Brummi/3D-Scanner/images/IMG_20150919_205852.jpg

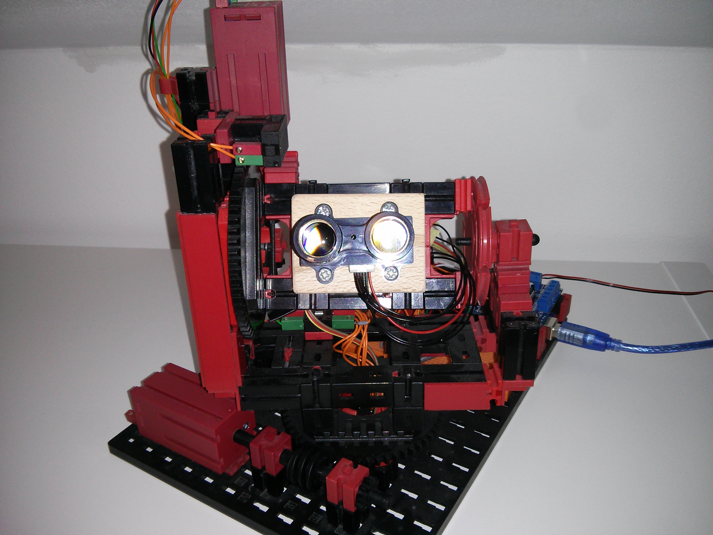
images/IMG_20150919_205852.jpg
