Brummi/3D-Scanner/images/scanner_vorne.jpg

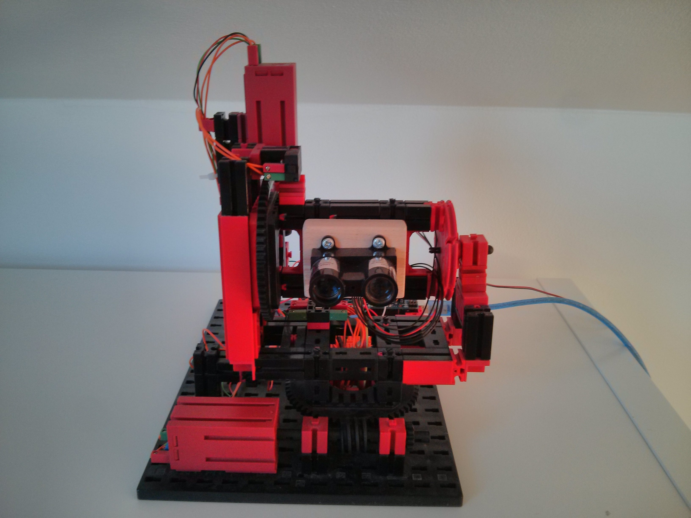
images/scanner_vorne.jpg
