Brummi/3D-Scanner/images/IMG_20150919_205907.jpg

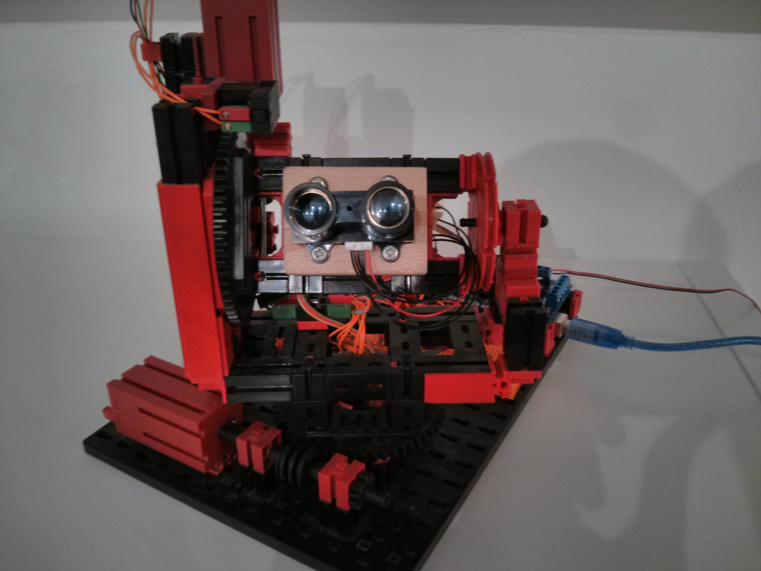
images/IMG_20150919_205907.jpg
