Brummi/3D-Scanner/images/IMG_20150919_205934.jpg

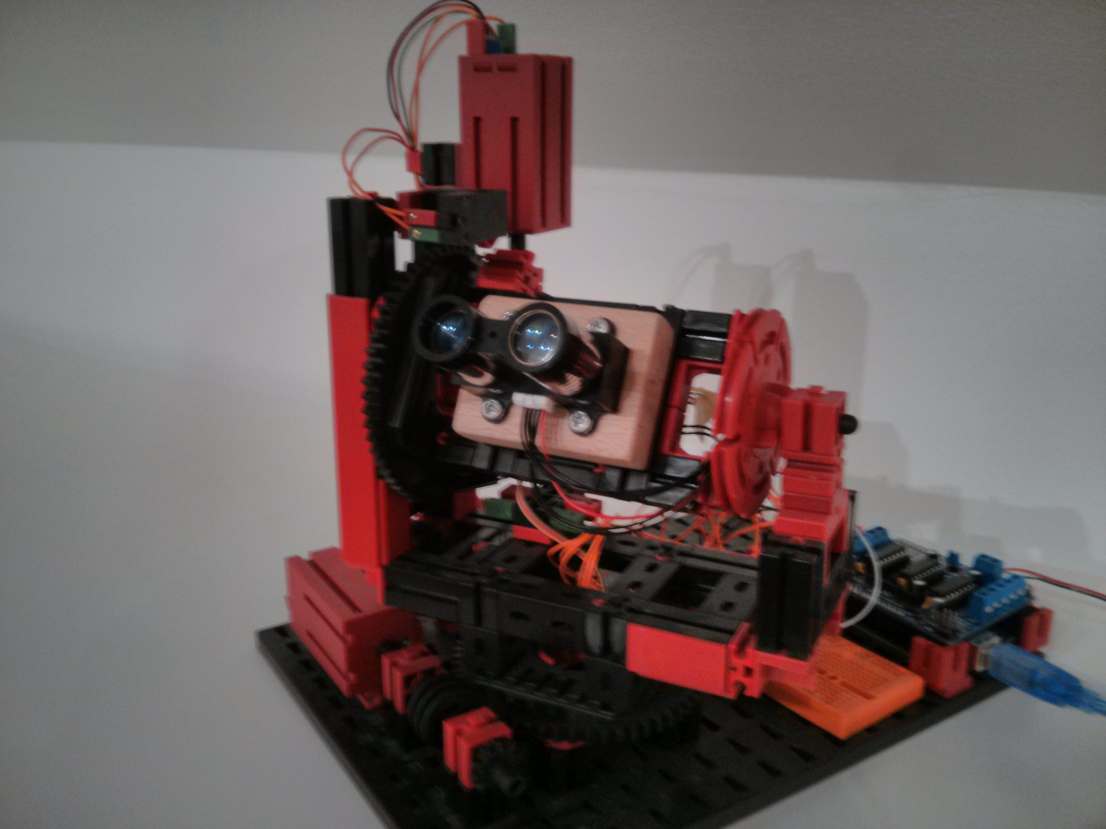
images/IMG_20150919_205934.jpg
