Brummi/3D-Scanner/images/scanner_hinten_schraeg.jpg

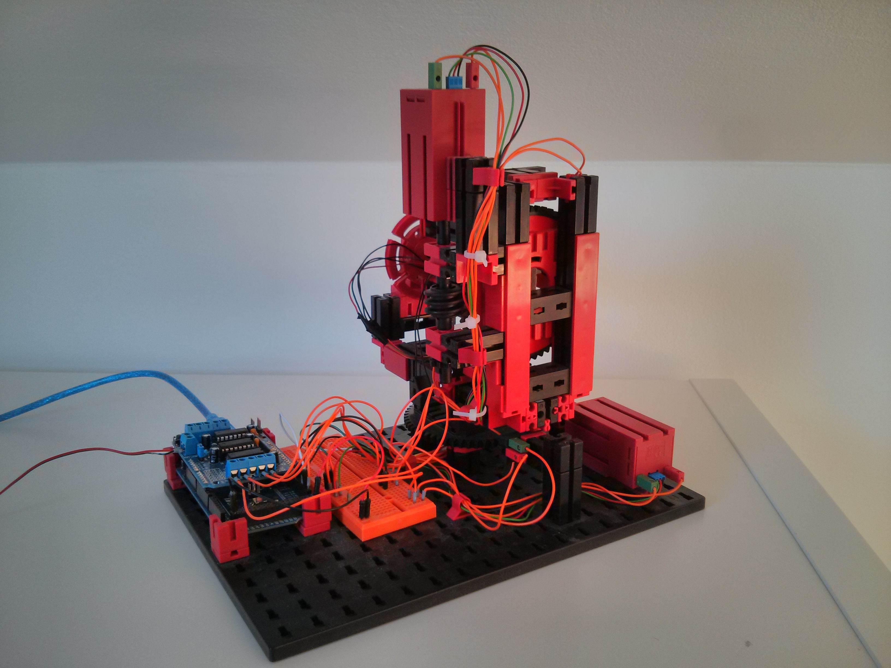
images/scanner_hinten_schraeg.jpg
