Brummi/3D-Scanner/images/scanner_vorne_schraeg.jpg

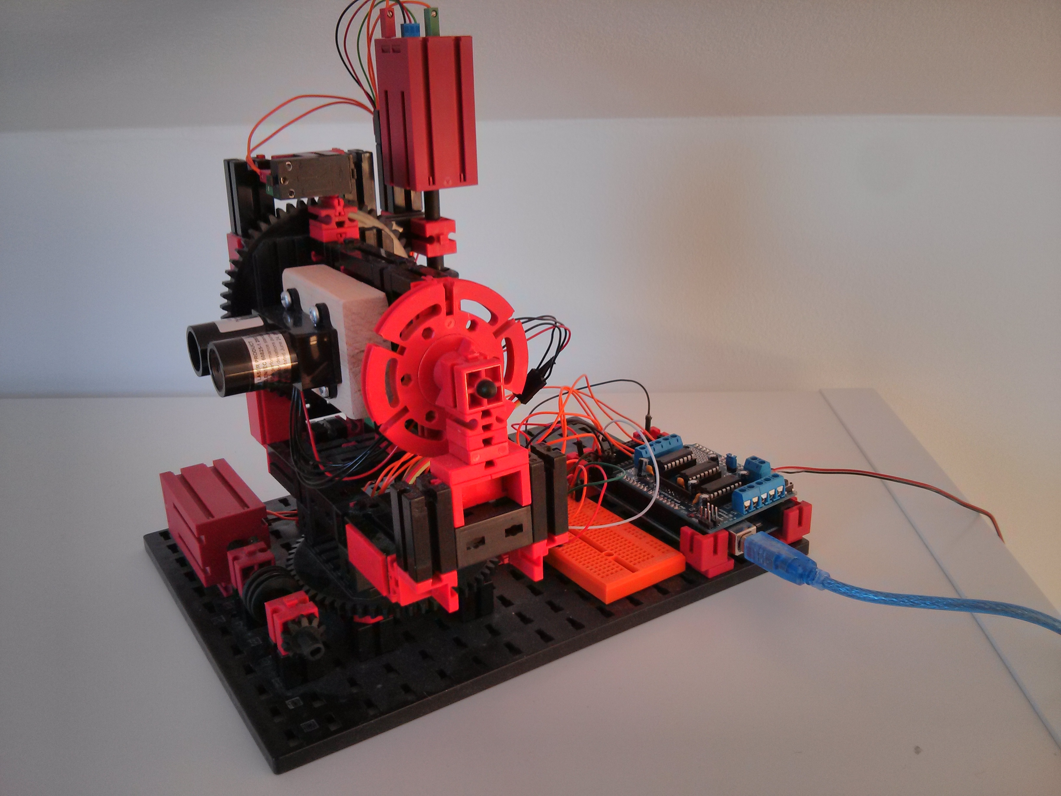
images/scanner_vorne_schraeg.jpg
