Brummi/3D-Scanner/(list of files, cad)

Other CAD files:
scanresulsts/scanErgebnis.obj
